ksu-denkouken/VFD_NTP_CLOCK/マニュアル/VFD_NTP_CLOCK_組み立てマニュアルV1.0.docx

Version

1.0

電気工学研究部

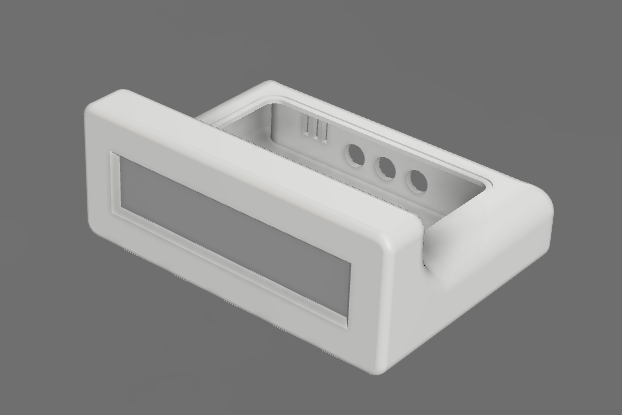
[picture p3: figure]

VFD_NTP_CLOCK_V1.0　組み立て・操作マニュアル

目次
