ksu-denkouken/VFD_NTP_CLOCK/部品/VFD_NTP_CLOCK_部品見積20230930a.xlsx

九州産業大学学友会電気工学研究部
VFD NTP CLOCK 部品見積 |  |  | 区分 | 活動費 | 援助金 | 見積
No. | 購入先 | 品目 | 数量 | 単価 | 小計 | 通販コード
1 | 秋月電子 | 分割ロングピンソケット１×４２ | 15 | 80 | 1200 | C-05779
2 | 秋月電子 | PS2010R １０個入り | 1 | 80 | 80 | I-02228
3 | 秋月電子 | TBD62783APG | 30 | 100 | 3000 | I-10957
4 | 秋月電子 | MC34063AN | 15 | 50 | 750 | I-12016
5 | 秋月電子 | 74HC595 | 15 | 40 | 600 | I-14053
6 | 秋月電子 | ESP32-DevKit-C-32E | 15 | 1600 | 24000 | M-15673
7 | 秋月電子 | DHT20 | 15 | 380 | 5700 | M-16732
8 | 秋月電子 | 丸ピンICソケット (16P) | 15 | 30 | 450 | P-00029
9 | 秋月電子 | 丸ピンICソケット (18P) | 30 | 40 | 1200 | P-00030
10 | 秋月電子 | 丸ピンICソケット (8P) | 15 | 15 | 225 | P-00035
11 | 秋月電子 | 電解コンデンサ220uF35V105℃ルビコンZLH | 15 | 20 | 300 | P-02718
12 | 秋月電子 | 積層セラミックコンデンサ 1000pF 50V X7R 5mm １０個入 | 2 | 100 | 200 | P-08132
13 | 秋月電子 | 表面実装ヒューズ 125V 1A | 1 | 100 | 100 | P-09231
14 | 秋月電子 | MPFコンデンサ 0.1uF 100V | 15 | 20 | 300 | P-09790
15 | 秋月電子 | 圧電スピーカー PKM13EPYH4000-A0 | 15 | 30 | 450 | P-04118
16 | 秋月電子 | 電解コンデンサ220uF16V105℃ルビコンPX | 15 | 10 | 150 | P-10272
17 | 秋月電子 | インダクター 100uH 1.9A RCH114NP-101KB | 15 | 80 | 1200 | P-16968
18 | 秋月電子 | 積層セラミックコンデンサ 50V 0.1uF X7R 2.54mm １０個入り | 8 | 100 | 800 | P-13582
19 | 秋月電子 | 半固定ボリューム GF063P 1kΩ | 15 | 30 | 450 | P-14901
20 | 秋月電子 | 炭素被膜抵抗器 1/2W 1kΩ １００個入 | 1 | 150 | 150 | R-07820
21 | 共立電子 | 9桁 7セグ蛍光表示管 (15個入)FIP9B8-15P | 1 | 3000 | 3000 | M8N41I
22 | 共立電子 | 共立電子送料 | 1 | 550 | 550
23 | PCBgogo | 2層プリント基板 15枚 + 送料(DHL) | 1 | ５３ドル | 約８０００円
24 | ダイソー | USB-A-microBケーブル | 15 | 110 | 1650
25 | ダイソー | USB充電器 | 15 | 330 | 4950
26 | ダイソー | クリアハードUVレジン | 10 | 110 | 1100
27 | コーナン | ゴム足 8.5mm丸×2.2mm 15個入り | 4 | 217 | 868
28 |  | 表示窓2mm透明アクリル板 およそ100×37 | 15 | 0 | 0
29 |  | 天面2mm透明アクリル板 およそ82×40 | 15 | 0 | 0
30 |  |  |  |  | 0
31 |  |  |  |  | 0
32 |  |  |  |  | 0
33 |  |  |  |  | 0
34 |  |  |  |  | 0
35 |  |  |  |  | 0
 |  |  |  | 計 | 53423 | "+基板代,アクリル代"
