ksu-denkouken/VFD_NTP_CLOCK/部品/VFD_NTP_CLOCK購入品リスト.xlsx

Sheet: 購入品リスト
電気工学研究部 |  |  | バージョン | 1 |  | 承認 |  | 確認 |  | 作成/担当
購入品リスト |  |  |  | 状態 |  |  |  |  |  | 日野
 |  |  |  | 見積用
名称 |  | VFD_NTP_CLOCK |  |  | 台数
基板バージョン |  | 1.1 |  |  | 10 |  |  |  |  | 2023-09-07
※送料は、秋月電子11,000円以上で無料、共立電子5,500円以上で無料
項 | 名称 |  |  | 調達先 | 数量（個,パック） |  | 単価 |  | 価格 |  | 備考
 | 通販コード |  |  |  | 各 | 合計
1 | 分割ロングピンソケット |  |  | 秋月電子通商 | 1 | 10 | ¥80 |  | ¥800
 | C-05779
2 | 高速整流ダイオードPS2010 |  |  | 秋月電子通商 | 1 | 1 | ¥80 |  | ¥80 |  | 1パック10個入り
 | I-02228
3 | トランジスタ2SC1815 |  |  | 秋月電子通商 | 1 | 1 | ¥100 |  | ¥100 |  | 1パック10個入り
 | I-06477
4 | トランジスタアレイTBD62783 |  |  | 秋月電子通商 | 2 | 20 | ¥100 |  | ¥2000
 | I-10957
5 | MC34063AN |  |  | 秋月電子通商 | 1 | 10 | ¥50 |  | ¥500
 | I-12016
6 | 74HC595AG |  |  | 秋月電子通商 | 1 | 10 | ¥40 |  | ¥400
 | I-14053
7 | ESP32-DevKitC-32E |  |  | 秋月電子通商 | 1 | 10 | ¥1600 |  | ¥16000
 | M-15673
8 | 温湿度センサDHT20 |  |  | 秋月電子通商 | 1 | 10 | ¥380 |  | ¥3800
 | M-16732
9 | 16P丸ピンICソケット |  |  | 秋月電子通商 | 1 | 10 | ¥30 |  | ¥300
 | P-00029
10 | 18P丸ピンICソケット |  |  | 秋月電子通商 | 2 | 20 | ¥40 |  | ¥800
 | P-00030
11 | 積層セラミックコンデンサ50V2200pF |  |  | 秋月電子通商 | 1 | 1 | ¥100 |  | ¥100 |  | 1パック10個入り
 | P-08134
12 | 表面実装ヒューズ125V1A |  |  | 秋月電子通商 | 1 | 10 | ¥100 |  | ¥1000 |  | 1パック10個入り
 | P-09231
13 | MPFコンデンサ 0.1uF 100V |  |  | 秋月電子通商 | 1 | 10 | ¥20 |  | ¥200
 | P-09790
14 | 電子ブザー 12mm UGCM1205XP |  |  | 秋月電子通商 | 1 | 10 | ¥70 |  | ¥700
 | P-09800
15 | 電解コンデンサ 220uF 16V |  |  | 秋月電子通商 | 1 | 10 | ¥10 |  | ¥100
 | P-10272
16 | インダクター 220uH 1.1A |  |  | 秋月電子通商 | 1 | =F5*F39 | ¥100 |  | ¥100
 | P-13551
17 | 積層セラミックコンデンサ50V0.1uF |  |  | 秋月電子通商 | 6 | =(F5/10)*F41 | ¥100 |  | ¥100 |  | 1パック10個入り
 | P-13582
18 | 半固定ボリューム GF063P 1kΩ |  |  | 秋月電子通商 | 1 | =F43*F5 | ¥30 |  | ¥30
 | P-14901
19 | 8P丸ピンICソケット |  |  | 秋月電子通商 | 1 | 1 | ¥15 |  | ¥15
 | P-00035
20 | 電解コンデンサ 220uF 35V |  |  | 秋月電子通商 | 1 | 2 | ¥20 |  | ¥40
 | P-02718
21 | 1/2W カーボン抵抗器 1kΩ |  |  | 秋月電子通商 | 6 |  | ¥100 |  | ¥100 |  | 1パック100個入り
 | R-07820
秋月電子合計価格 |  |  |  |  |  |  |  |  | ¥27265
秋月電子送料 |  |  |  |  |  |  |  |  | ¥0
22 | VFD FIP9B8 |  |  | 共立電子 | 1 | 1 | 3000 |  | 3000 |  | 1セット15個入り
 | FIP9B8-15P
共立電子送料 |  |  |  |  |  |  |  |  | ¥550
23 | クリアハード UVレジン |  |  | ダイソー
24 | 瞬間接着剤 |  |  | ダイソー
25 |  |  |  | ダイソー
26 |  |  |  | ダイソー
27 |  |  |  | ダイソー

Sheet: 購入品見積リスト
Confidential |  |  | 工事No | 000000-000000 |  |  |  | 確認 |  | 作成/担当
購入品見積リスト |  |  |  |  |  |  |  |  |  | A
適用組立図 |  | 全体組立図 |  |  | 台数
図面番号 |  | 003-001 |  |  | 2 |  |  |  |  | 2017-09-19
※ |  |  |  |  |  |  | 金額
項 | 名称 |  |  | メーカー | 数量（個,式） |  | 単価 |  | 税込 | ¥4553.28
 | 型式 |  |  |  | 各 | 合計 |  |  | 合計 | ¥4216
1 | 購入品A |  |  |  | 2 | 4 | ¥300 |  | ¥1200
 | AAA-AAAA
2 | 購入品B |  |  |  | 2 | 4 | ¥301 |  | ¥1204
 | BBB-BBBB
3 | 購入品C |  |  |  | 3 | 6 | ¥302 |  | ¥1812
 | CCC-CCCC
4 |  |  |  |  |  | 0 |  |  | ¥0
5 |  |  |  |  |  | 0 |  |  | ¥0
6 |  |  |  |  |  | 0 |  |  | ¥0
7 |  |  |  |  |  | 0 |  |  | ¥0
8 |  |  |  |  |  | 0 |  |  | ¥0
9 |  |  |  |  |  | 0 |  |  | ¥0
10 |  |  |  |  |  | 0 |  |  | ¥0
11 |  |  |  |  |  | 0 |  |  | ¥0
12 |  |  |  |  |  | 0 |  |  | ¥0
13 |  |  |  |  |  | 0 |  |  | ¥0
14 |  |  |  |  |  | 0 |  |  | ¥0
15 | ケーブルベア |  |  |  |  | 0 |  |  | ¥0
 | 本体：
 | 固定金具：
 | 移動端金具：
 | 縦仕切板：
 | ｴﾝﾄﾞｽﾄｯﾊﾟ付横仕切板：
 | 編成：
