ksu-denkouken/VFD_NTP_CLOCK/部品/試作部品リスト.xlsx

NO. | 購入先 | 名称 | 通販コード | 価格 | 数量 | 合計 | 備考 | 秋月電子通商 | 小計 | 送料 | 手数料 | 合計
1 | 秋月電子通商 | ＵＳＢ Ｔｙｐｅ－Ｃコネクタ 基板用 | C-14356 | 110 | 1 | 110 |  |  |  | 500 | 300 | 800
2 |  | ８ｃｈソースタイプＤＭＯＳトランジスタア レイ ＴＢＤ６２７８３ＡＰＧ | I-10957 | 100 | 2 | 200
3 |  | ５ｍｍ赤色ＬＥＤ ６２５ｎｍ ＯＳＨＲ５ １６１Ａ－ＲＳ （１０個入） | I-13707 | 120 | 1 | 120
4 |  | 電池ボックス 単４×４本 リード線 | P-03087 | 70 | 1 | 70 |  | 共立エレショップ | 小計 | 送料 | 手数料 | 合計
5 |  | 電子ブザー １２ｍｍ ＵＧＣＭ１２０５Ｘ Ｐ | P-09800 | 70 | 1 | 70 |  |  |  | 550 | 0 | 550
6 |  | タクトスイッチ １２ｍｍ ＴＶＧＰ０１－ Ｇ７３ＢＢ（黒） | P-09826 | 30 | 1 | 30
7 |  | タクトスイッチ １２ｍｍ ＴＶＧＰ０１－ Ｇ７３ＢＢ（赤） | P-09827 | 30 | 1 | 30
8 |  | 接着式サポート ペテット Ｔ－６００ | P-09950 | 50 | 4 | 200 |  | ダイソー | 小計 | 送料 | 手数料 | 合計
9 |  | リセッタブルヒューズ ０．２Ａ トリップ 電流：０．４Ａ 耐圧：７２Ｖ ＭＦ－ＲＸ ０２０／７２－０ | P-12631 | 30 | 1 | 30 |  |  |  | 0 | 0 | 0
10 |  | スライドスイッチ ＳＳ２２Ｅ０１Ｇ５－Ｈ Ａ－Ｇ | P-15371 | 30 | 2 | 60
11 |  | チップアルミ電解コンデンサー ４７０μＦ １６Ｖ１０５℃ ＣＥ－ＦＳ （１０個入） | P-16891 | 120 | 1 | 120
12 |  |  |  |  |  |  |  |  | 小計 | 送料 | 手数料 | 合計
13 |  |  |  |  |  |  |  |  |  | 550 | 0 | 550
14
15
16 |  |  |  |  |  |  |  |  |  |  | 合計
17 |  |  |  |  |  |  |  |  |  |  | 1350
18
19
20
21
22
23
24
25
26
27
28
29
30
31
32
33
34
35
36
37
38
39
40
41
42
43
44
45
46
47
48
NO. | 購入先 | 名称 | 通販コード | 価格 | 数量 | 合計 | 備考
1 | 共立エレショップ
2
3
4
5
6
7
8
9
10
11
12
13
NO. | 購入先 | 名称 | 通販コード | 価格(税込) | 数量 | 合計 | 備考
1 | ダイソー | クリアケース ワイド |  | 110 | 1
2 |  | フタ付きBOX |  | 110 | 1
3 |  | 段ボール |  | 110 | 1
4 |  |  |  | 110 | 1
5 |  |  |  | 110 | 1
6 |  |  |  | 110 | 1
7 |  |  |  | 110 | 1
8 |  |  |  | 110 | 1
9
10
11
12
13
