ksu-denkouken/VFD_NTP_CLOCK/部品/共立エレショップ/2桁蛍光表示管■限定特価品■ _ FG213C10-DJK_files/fg213c10d.png

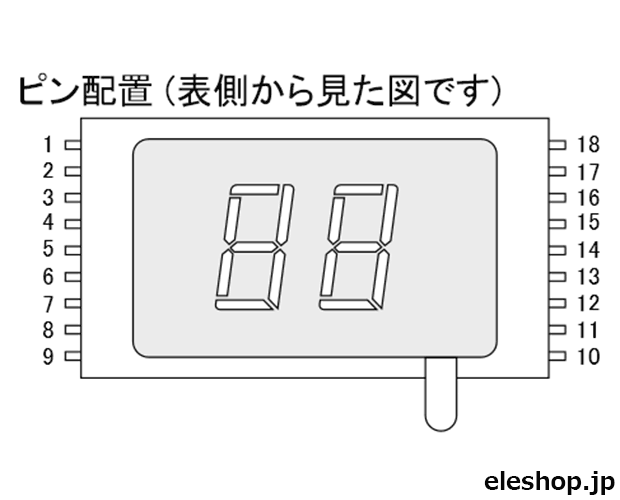
部品/共立エレショップ/2桁蛍光表示管■限定特価品■ _ FG213C10-DJK_files/fg213c10d.png
