ksu-denkouken/VFD_NTP_CLOCK/部品/共立エレショップ/横押し形タクタイルスイッチ (100個入) ■限定特価品■ _ B3F-3102-100P_files/B3F3102100Pc.jpg

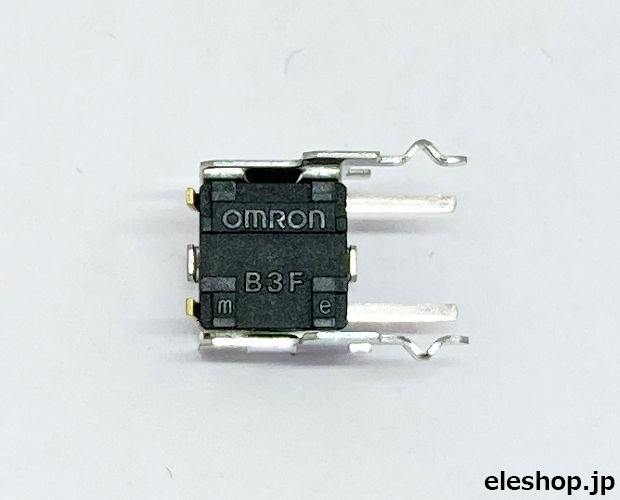
部品/共立エレショップ/横押し形タクタイルスイッチ (100個入) ■限定特価品■ _ B3F-3102-100P_files/B3F3102100Pc.jpg
