ksu-denkouken/VFD_NTP_CLOCK/筐体/アクリル板/VFD_NTP_CLOCK_PLATE_T_V1.0 v3.stl

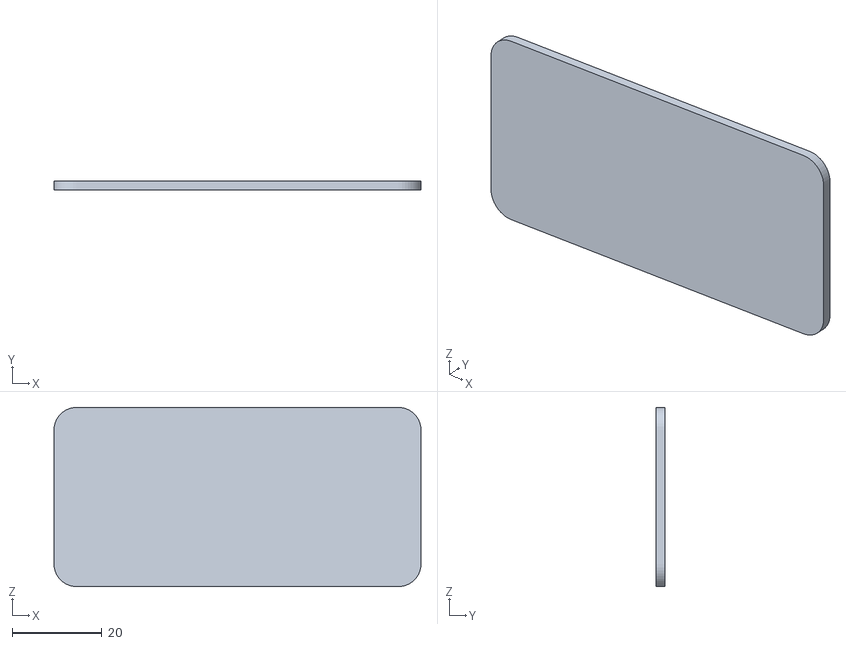
[picture p14: CAD file, 2024-03-23]
筐体/アクリル板/VFD_NTP_CLOCK_PLATE_T_V1.0 v3.stl
82.0 x 2.00 x 40.0
