ksu-denkouken/VFD_NTP_CLOCK/筐体/本番/ケース/VFD_NTP_CLOCK_CASE_V1.1 v2.stl

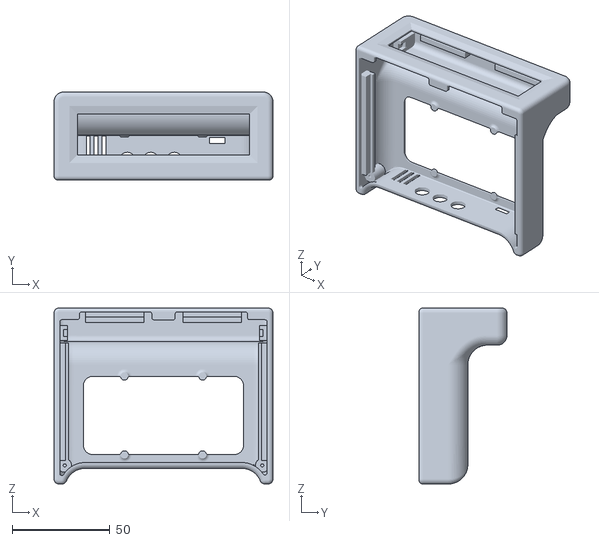
[picture p15: CAD file, 2024-03-23]
筐体/本番/ケース/VFD_NTP_CLOCK_CASE_V1.1 v2.stl
112.0 x 45.0 x 90.0
