ksu-denkouken/VFD_NTP_CLOCK/筐体/本番/プレート/VFD_NTP_CLOCK_PLATE_V2.1 v4.stl

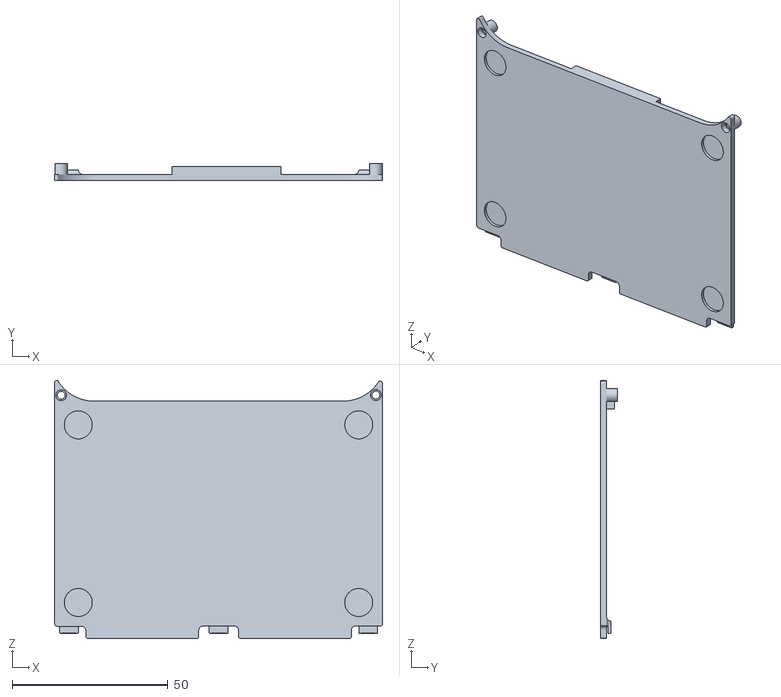
[picture p16: CAD file, 2024-03-23]
筐体/本番/プレート/VFD_NTP_CLOCK_PLATE_V2.1 v4.stl
105.3 x 5.60 x 82.9
