ksu-denkouken/VFD_NTP_CLOCK/筐体/本番/ボタン/VFD_NTP_CLOCK_BUTTON_V2.2 v2.stl

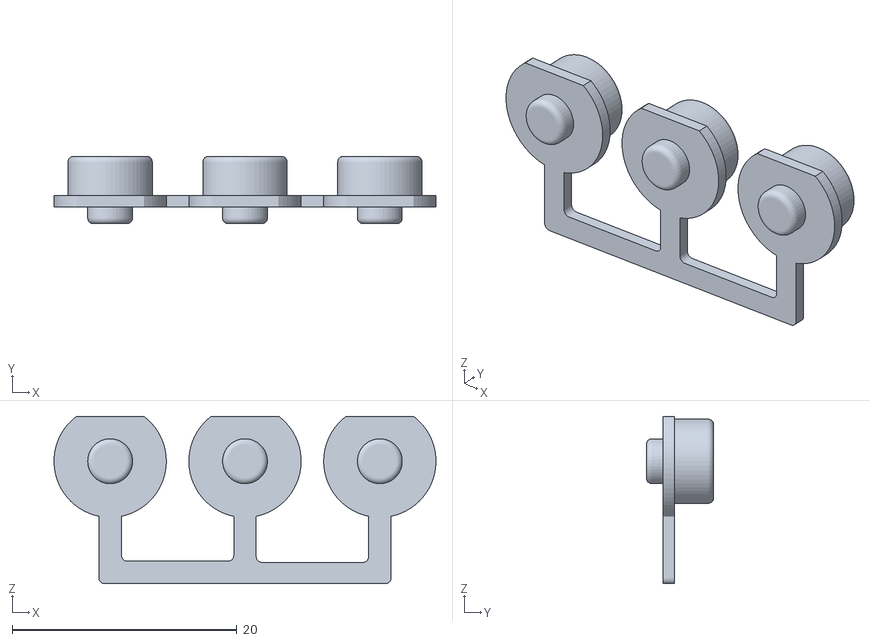
[picture p17: CAD file, 2024-03-23]
筐体/本番/ボタン/VFD_NTP_CLOCK_BUTTON_V2.2 v2.stl
34.0 x 6.00 x 14.9
