ksu-denkouken/VFD_NTP_CLOCK/筐体/構想/VFD時計構想V5.0 v2.stl

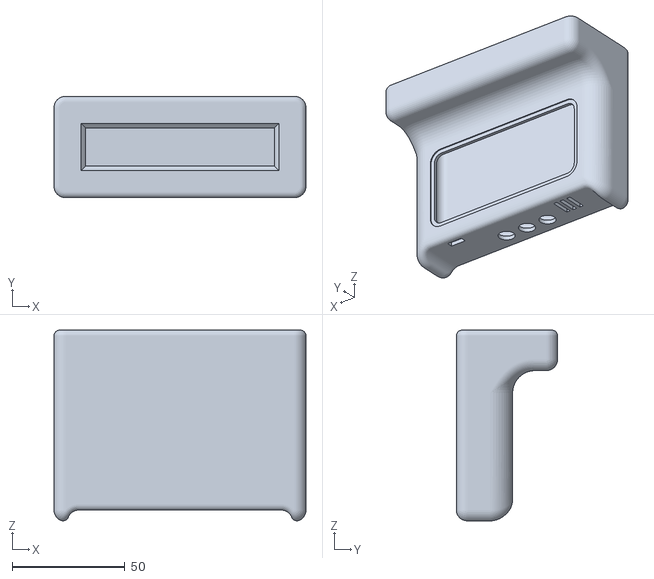
[picture p18: CAD file, 2024-03-23]
筐体/構想/VFD時計構想V5.0 v2.stl
112.0 x 45.0 x 84.8
