ksu-denkouken/VFD_NTP_CLOCK/筐体/アクリル板/VFD_NTP_CLOCK_PLATE_F_V1.0 v3.stl

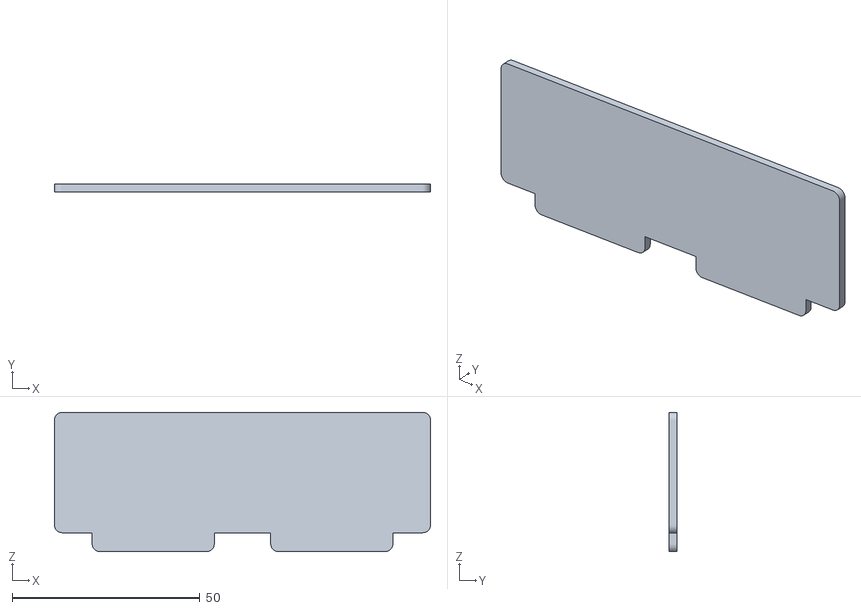
[picture p19: CAD file, 2024-03-23]
筐体/アクリル板/VFD_NTP_CLOCK_PLATE_F_V1.0 v3.stl
100.0 x 2.00 x 37.0
