ksu-denkouken/VFD_NTP_CLOCK/筐体/構想/VFD時計構想V6.0 v11.stl

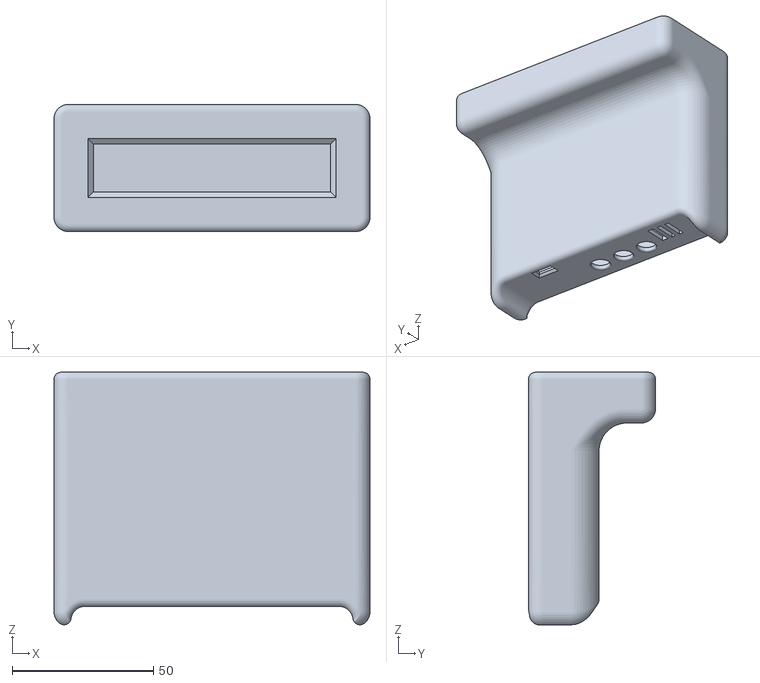
[picture p20: CAD file, 2024-03-23]
筐体/構想/VFD時計構想V6.0 v11.stl
112.0 x 45.0 x 89.5
