ksu-denkouken/VFD_NTP_CLOCK/筐体/構想/VFD時計構想V3.0 v1.stl

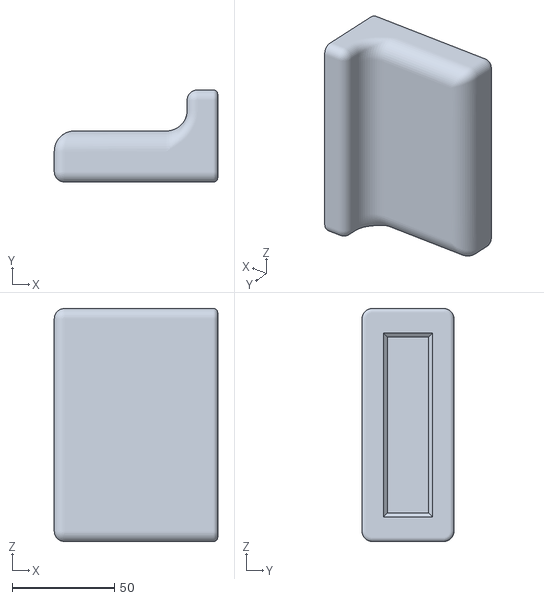
[picture p21: CAD file, 2024-03-23]
筐体/構想/VFD時計構想V3.0 v1.stl
80.0 x 45.0 x 114.0
