ksu-denkouken/VFD_NTP_CLOCK/筐体/構想/VFD時計構想V1.0 v3.stl

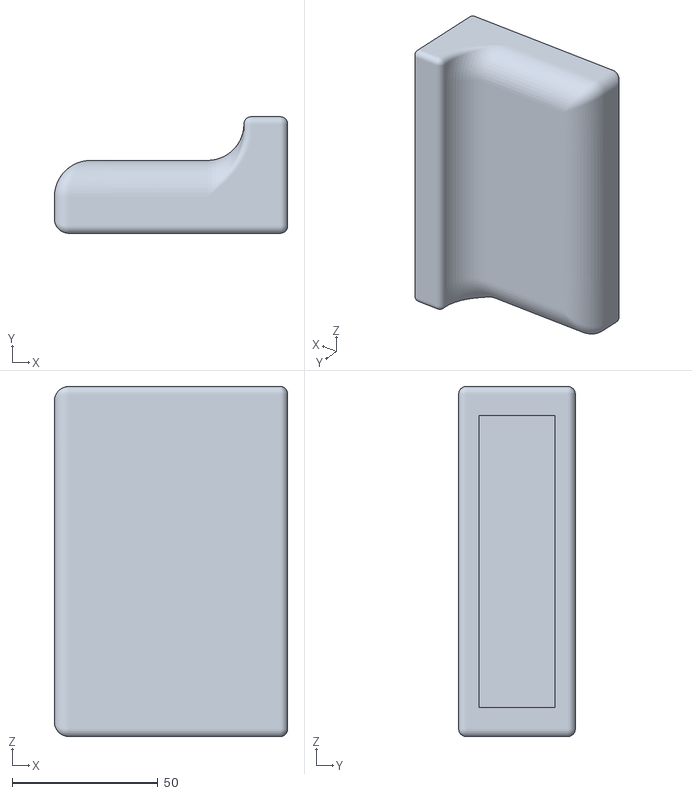
[picture p22: CAD file, 2024-03-23]
筐体/構想/VFD時計構想V1.0 v3.stl
80.0 x 40.0 x 120.0
