ksu-denkouken/VFD_NTP_CLOCK/筐体/構想/VFD時計構想V2.0 v2.stl

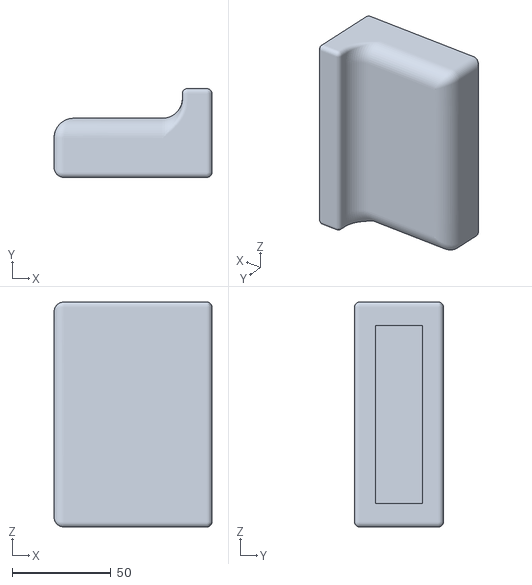
[picture p23: CAD file, 2024-03-23, an earlier design]
筐体/構想/VFD時計構想V2.0 v2.stl
80.0 x 45.0 x 114.0
