ksu-denkouken/VFD_NTP_CLOCK/(list of files, cad)

Other CAD files:
筐体/構想/VFD時計構想V4.0 v5.stl
筐体/アクリル板/VFD_NTP_CLOCK_PLATE_F_V1.0 v3.f3d
筐体/アクリル板/VFD_NTP_CLOCK_PLATE_T_V1.0 v3.f3d
筐体/本番/ケース/VFD_NTP_CLOCK_CASE_V1.1 v1.f3d
筐体/本番/プレート/VFD_NTP_CLOCK_PLATE_V2.1 v3.f3d
筐体/本番/ボタン/VFD_NTP_CLOCK_BUTTON_V2.2 v2.f3d
筐体/構想/VFD時計構想V1.0 v6.f3d
筐体/構想/VFD時計構想V2.0 v3.f3d
筐体/構想/VFD時計構想V3.0 (v1~recovered).f3d
筐体/構想/VFD時計構想V4.0 v5.f3d
筐体/構想/VFD時計構想V5.0 v2.f3d
筐体/構想/VFD時計構想V6.0 v11.f3d
