ksu-denkouken/VFD_NTP_CLOCK/電子工作講習会ページ/VFD_NTP_CLOCK_回路図_V2.0.pdf

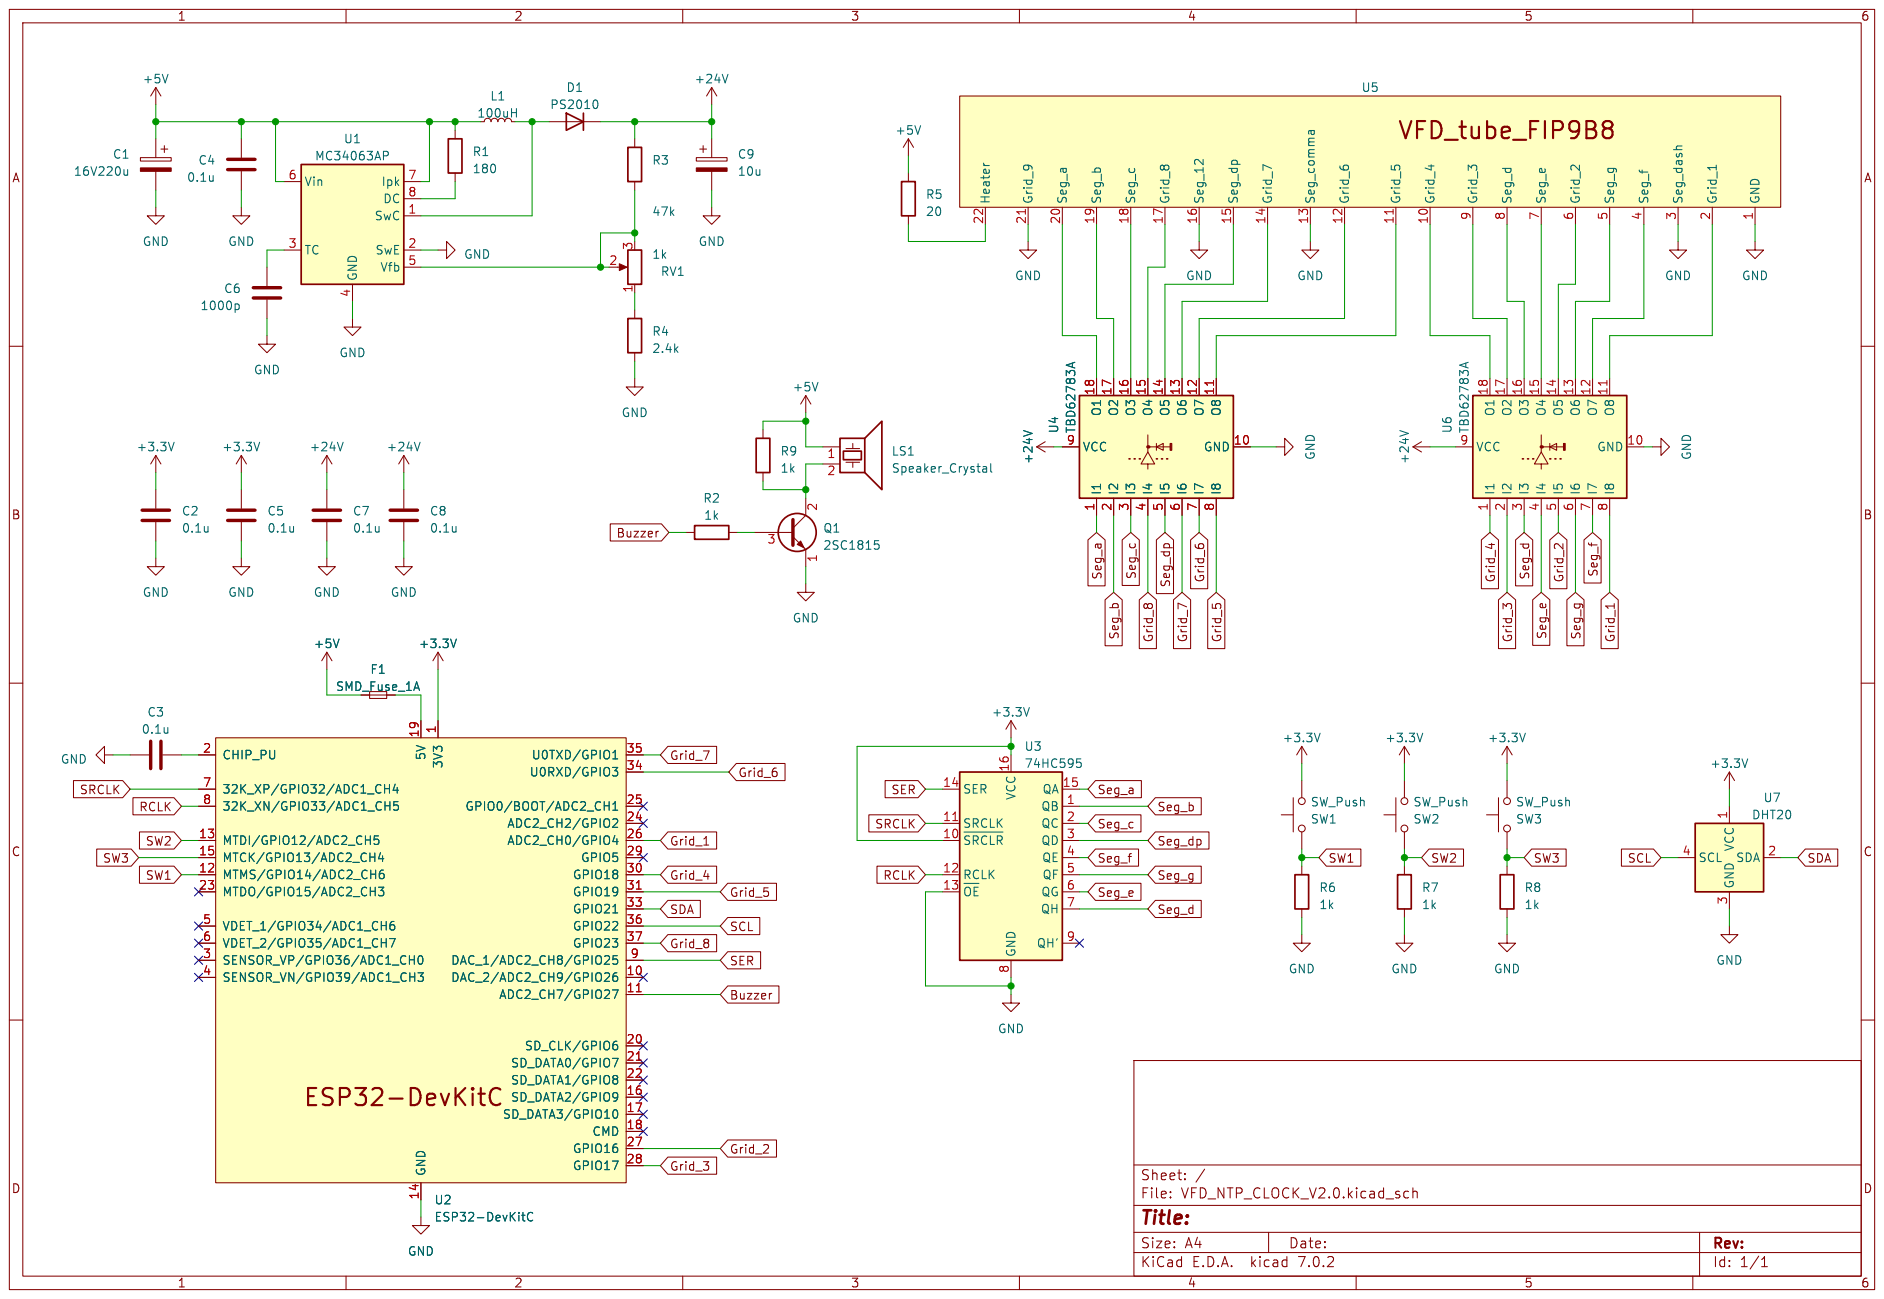
[picture p24: page 1]

9 U5 GND GND GND GND GND I1

1 DAC_2/ADC2_CH9/GPIO26 10 ADC2_CH7/GPIO27 11 MTMS/GPIO14/ADC2_CH6 12 MTDI/GPIO12/ADC2_CH5 13 MTCK/GPIO13/ADC2_CH4 15 SD_DATA2/GPIO9 16 SD_DATA3/GPIO10 17 CMD 18 CHIP_PU 2 SD_CLK/GPIO6 20 SD_DATA0/GPIO7 21 SD_DATA1/GPIO8 22 MTDO/GPIO15/ADC2_CH3 23 ADC2_CH2/GPIO2 24 GPIO0/BOOT/ADC2_CH1 25 ADC2_CH0/GPIO4 26 GPIO16 27 GPIO17 28 GPIO5 29 SENSOR_VP/GPIO36/ADC1_CH0 3 GPIO18 30 GPIO19 31 GPIO21 33 U0RXD/GPIO3 34 U0TXD/GPIO1 35 GPIO22 36 GPIO23 37 SENSOR_VN/GPIO39/ADC1_CH3 4 VDET_1/GPIO34/ADC1_CH6 5 VDET_2/GPIO35/ADC1_CH7 6

Id: 1/1 Title: File: VFD_NTP_CLOCK_V2.0.kicad_sch Sheet: /
